evg2000/ATTiny84_Version3.1/README.md

# ATTiny84_Version3.1 Intellivision and ColecoVision Paddle Controller
 Paddle controller version 3.1. ATTiny84 version.
 
 The links in the PDF only work if you download it.  They don't seem to work if viewed in the browser.
